mappite/aGotino/aGotino-wiring.png

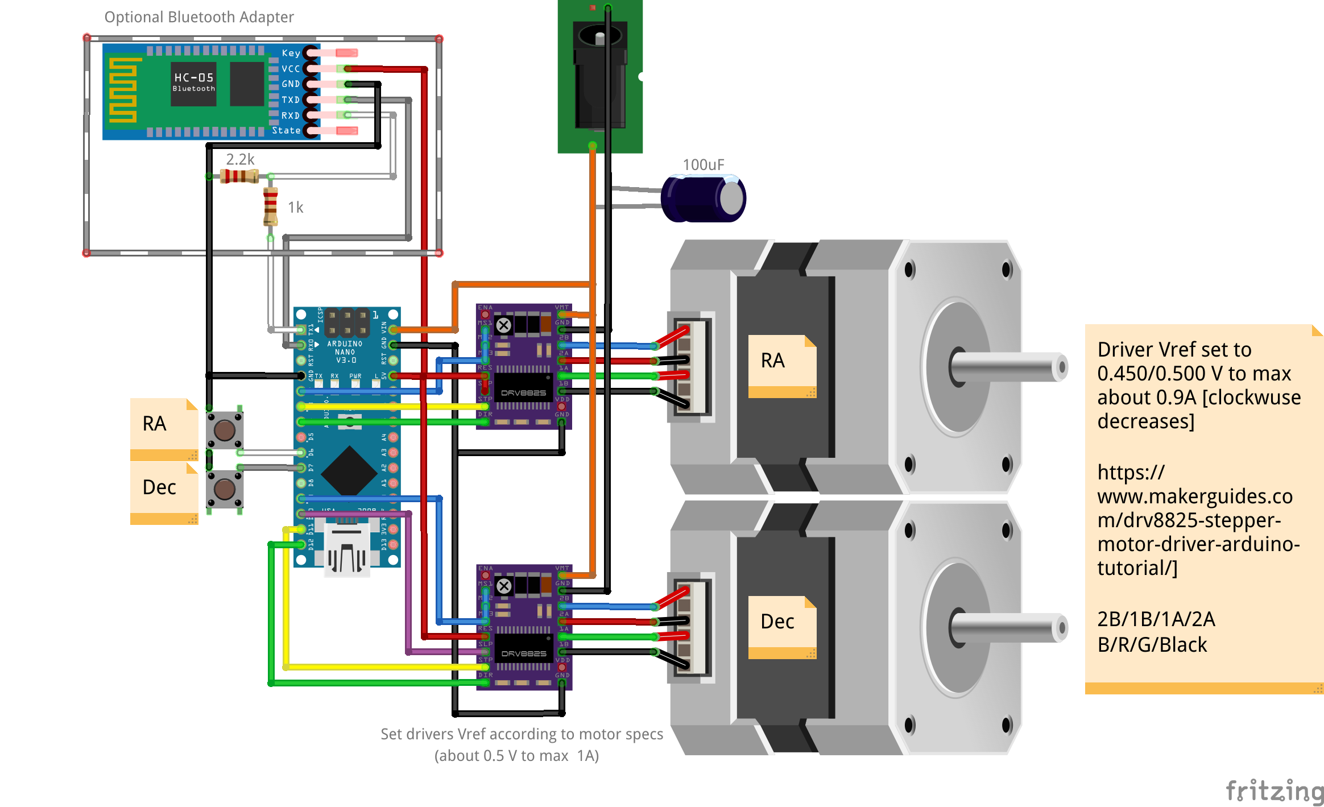
aGotino-wiring.png
