mappite/aGotino/(threads)

Thread 5 (2021-02-19):

Wrong GVP and GVN responses

polakovic, 2021-02-19:
Responses are not ended with '#' and thus protocol dialect detection is not possible.

eliboni, 2021-02-19:
Peter many thanks for the finding, you're right the final # is missed but it is required as per protocol specs. We'll fix it soon.

eliboni, 2021-02-20:
Fixed in main

eliboni, 2021-07-17:
@polakovic the issue is closed since some time but pls if you can confirm it is solved  I would appreciate. Thanks

polakovic, 2021-07-17:
Unfortunately I don't have such mount so I can't confirm it :(

Closed 2021-02-20.

Thread 6 (2022-01-04):

Figuring out maths for different mounts...

pepsiaddict82, 2022-01-04:
Hey I am just wondering about how to go about getting this rather important numbers right, first let me say thanks for your project and I hope to have it figured out here and be able to use it without having to make guesses in setting it all up!

Ok so I have a mount, its an astromaster mount, from what I can gather often times being called an eq2, now I understand its not the best mount to convert, but its what I have, as often is the argument when it comes to DIY stuff :) now then, when trying to figure out the maths,, I am instantly stuck on gathering numbers to input for a couple reasons, hopefully I can get some clarity.

First is the fact that I am direct driving the RA motor, so motor>coupler>RA worm..that spins the large gear on the RA. Question being the worm gear, how does one go about getting a number of teeth here?
For the DEC I have a large and small gear, so thats fine, but documentation doesnt really make things clear, as well the belt calculator you link to is largely irrelevant to most I assume, because this being a DIY project, can probably be safe to assume that mounting of motors is going to vary largely.

I am also quite curious about using the 2209's as drivers, I understand that for the most part these drivers pins are much the same, but just wanted to get a definitive understanding of what to connect where, being that one could argue the 2209 being the most popular driver in the wild today...

Not even sure if youre still doing anything with this project, but I figured I would take a shot and ask here first, rather than a 3rd party site.

Thanks for your time

eliboni, 2022-01-06:
I suggest to post this question on CloudyNight/Stargazer  or similar forums where somebody may already know the answers your are looking  for an eq2. One way to find the worm gear ratio is to mark the initial RA position and turn knob n times until the marker is back to the original position (if I remember correctly it could be 1:138). For the driver I can't help much, this is the issue list for agotino code, you'll get more inputs in astronomy diy forums.

Closed 2022-03-03.

Thread 8 (2022-09-01):

Is there a way to convert this code for alt-az mount

Neoxxgr, 2022-09-01:

eliboni, 2022-09-07:
Hi Neoxxgr, well the right answer is "yes" but the effort is quite big.

The main challenge is that to convert eq coordinates to az ones, we need to now exact lat/lng of the scope plus the exact sidereal time: so this information need to be passed to aGotino, then aGotino shoudl do the math and drive the motors-

https://www.cloudynights.com/topic/652374-open-source-conversion-between-eq-and-az-coordinates/
https://www.astrogreg.com/convert_ra_dec_to_alt_az.html

Thread 11 (2022-11-19):

Calcolo ingranaggi e cinghia

sazizz, 2022-11-19:
Ciaooo, innanzitutto mitico il lavoro che hai svolto per aGotino tant'è che sto provando ad applicarlo sulla mia montatura Meade lXD 300, unico problema (momentaneamente) è il calcolo ingranaggi  e cinghia che non ho assolutamente capito 😅 quindi ti chiederei una mano se è possibile,  ho due ingranaggi uno da 16 ed uno da 60 denti 2mm ed una distanza di circa 4 cm dal centro dei due ingranaggi, come faccio a calcolare effettivamente la cinghia? Grazie milleeee

eliboni, 2022-11-20:
@sazizz non mi è chiaro che calcolo ti serve, se hai i due ingranaggi il rapporto  60/16 è 3.75 quindi devi usare questo fattore per calcolare  MICROSTEPS_PER_DEGREE_AR  = WormRatio*(3.75)*StepsPerRevolution*Microsteps/360
Il WormRatio dipende dalla montatura, mentre StepsPerRevolution e Microsteps dipendono dal tipo di motore. Lunghezza cinghis o diametro ingranaggi è ininfluente per il calcolo (non cambia i rapporti).

In ogni caso, questa discussione su GitHub è per aspetti tecnici/contributi al codice etc, per domande generiche puoi utilizzare: https://www.astronomia.com/forum/showthread.php?34605-aGotino-un-goto-con-Arduino

Ciao!

Thread 13 (2023-11-08):

Bluetooth communication problem

martinapri, 2023-11-08:
Hello, I have connected via bluetooth with android smartphone and HC-05 appliance and received "aGotino ready"  welcome, but when I am sending any command, for example: s m31 no response receiving. I see RX led blinking for a moment, so my command was received but no information is generating in Serial Bluetooth Terminal.

Closed 2023-11-12.
