mappite/aGotino/catalogs.h

/* aGotino catalog.h
 *  
 *  Contains 
 *   Messier objects (110),  aGotino Star List (238) in Epoch J2000
 *   NGC objects Up to mag 11 (738) in B2000
 * 
 *  Copy this file in same folder of aGotino.ino
 */
#include <avr/pgmspace.h>

#define ELEMENTS(x) (sizeof(x) / sizeof(x[0]))

typedef struct {
     long ra, dec;
}  RaDec; // 8 byte

/* Messier Catalog
 *  Source: Wikipedia https://en.wikipedia.org/wiki/Messier_object
 */
const RaDec Messier[] PROGMEM = {
{0,0},          // Dummy so M[n] is Mn
{20071,79252},  // M1 05h 34m 31.94s +22° 00′ 52.2″
{77607,-2964},  // M2 21h 33m 27.02s −00° 49′ 24″
{49331,102158}, // M3 13h 42m 11.62s +28° 22′ 38.2″
{59015,-95492}, // M4 16h 23m 35.22s −26° 31′ 32.7″
{55113,7491},   // M5 15h 18m 33.22s +02° 04′ 51.7″
{63600,-115980},// M6 17h 40.1m −32° 13′
{64431,-125254},// M7 17h 53m 51.2s −34° 47′ 34″
{65017,-87792}, // M8 18h 03m 37s −24° 23′ 12″
{62351,-66658}, // M9 17h 19m 11.78s −18° 30′ 58.5″
{61029,-14758}, // M10 16h 57m 8.92s −04° 05′ 58.07″
{67866,-22560}, // M11 18h 51.1m −06° 16′
{60434,-7015},  // M12 16h 47m 14.18s −01° 56′ 55″
{60101,131255}, // M13 16h 41m 41.24s +36° 27′ 35.5″
{63456,-11685}, // M14 17h 37m 36.15s −03° 14′ 45.3″
{77398,43801},  // M15 21h 29m 58.33s +12° 10′ 01.2″
{65928,-49740}, // M16 18h 18m 48s −13° 49′
{66026,-58236}, // M17 18h 20m 26s −16° 10′ 36″
{65994,-61680}, // M18 18h 19.9m −17° 08′
{61357,-94565}, // M19 17h 02m 37.69s −26° 16′ 05″
{64943,-82908}, // M20 18h 02m 23s −23° 01′ 48″
{65076,-81000}, // M21 18h 04.6m −22° 30′
{66983,-86057}, // M22 18h 36m 23.94s −23° 54′ 17.1″
{64608,-68460}, // M23 17h 56.8m −19° 01′
{65820,-66780}, // M24 18h 17m −18° 33′
{66696,-69300}, // M25 18h 31.6m −19° 15′
{67512,-33840}, // M26 18h 45.2m −09° 24′
{71976,81796},  // M27 19h 59m 36.340s +22° 43′ 16.09″
{66272,-89531}, // M28 18h 24m 32.89s −24° 52′ 11.4″
{73436,138684}, // M29 20h 23m 56s +38° 31′ 24″
{78022,-83447}, // M30 21h 40m 22.12 −23° 10′ 47.5″
{2564,148569},  // M31 00h 42m 44.3s +41° 16′ 09″
{2561,147115},  // M32 00h 42m 41.8s +40° 51′ 55″
{5630,110377},  // M33 01h 33m 50.02s +30° 39′ 37″
{9726,153960},  // M34 02h 42.1m +42° 46′
{22146,87660},  // M35 06h 09.1m +24° 21′
{20172,122884}, // M36 05h 36m 12s +34° 08′ 04″
{21138,117182}, // M37 05h 52m 18s +32° 33′ 02″
{19722,129078}, // M38 05h 28m 42s +35° 51′ 18″
{77502,174360}, // M39 21h 31m 42s +48° 26′ 00″
{44532,209099}, // M40 12h 22m 12.5s +58° 04′ 59″
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
};

/* aGotino Star List
 *  Contains all constellations Alpha, Beta and Gamma stars 
 *  with mag < 4 and the all remaining stars with mag <3
 * Source: 
 *  BSC5P - Bright Star Catalog	https://heasarc.gsfc.nasa.gov/W3Browse/star-catalog/bsc5p.html
 *  Names from Kstars project https://edu.kde.org/kstars/ * 
 */

const RaDec Stars[] PROGMEM = {		
{0,324000},     // True North
{503,104726},  // (1) And Alp  Alpheratz
{4184,128234},  // (2) And Bet  Mirach
{7434,152387},  // (3) And Gam  Almach
{53272,-284561},  // (4) Aps Alp  
{59607,-284030},  // (5) Aps Gam  
{71447,31926},  // (6) Aql Alp  Altair
{71719,23064},  // (7) Aql Bet  Alshain
{71176,38208},  // (8) Aql Gam  Tarazed
{68725,49908},  // (9) Aql Zet  
{79547,1151}, // (10) Aqr Alp Sadalmelik
{77494,-20056}, // (11) Aqr Bet Sadalsud
{80499,-4994},  // (12) Aqr Gam Sadachbia
{63111,-179554},  // (13) Ara Alp Tchou
{62718,-199908},  // (14) Ara Bet 
{62724,-202959},  // (15) Ara Gam 
{7630,84465}, // (16) Ari Alp Hamal
{6878,74909}, // (17) Ari Bet Sheratan
{19001,165593}, // (18) Aur Alp Capella
{21572,161811}, // (19) Aur Bet Menkalinan
{18118,157764}, // (20) Aur Eps Maaz
{17820,119398}, // (21) Aur Iot Kabdhilinan
{21583,133965}, // (22) Aur The 
{51340,69057},  // (23) Boo Alp Arcturus
{54117,145406}, // (24) Boo Bet Nekkar
{53099,97467},  // (25) Boo Eps Pulcherrima
{50081,66232},  // (26) Boo Eta Muphrid
{52325,137910}, // (27) Boo Gam Seginus
{73083,-45161}, // (28) Cap Alp Al Giedi
{73261,-53213}, // (29) Cap Bet Dabih
{78422,-58058}, // (30) Cap Del Deneb Algiedi
{78006,-59984}, // (31) Cap Gam Nashira
{23037,-189705},  // (32) Car Alp Canopus
{33192,-250982},  // (33) Car Bet Miaplacidus
{30151,-214235},  // (34) Car Eps Avior
{33425,-213391},  // (35) Car Iot Aspidiske
{38577,-231820},  // (36) Car The 
{2431,203534},  // (37) Cas Alp Schedar
{551,212939}, // (38) Cas Bet Caph
{5149,216847},  // (39) Cas Del Ruchbah
{3403,218580},  // (40) Cas Gam Navi
{52776,-219007},  // (41) Cen Alp Rigel Kentaurus
{50629,-217343},  // (42) Cen Bet Hadar
{43702,-182601},  // (43) Cen Del 
{49193,-192479},  // (44) Cen Eps 
{52530,-151768},  // (45) Cen Eta 
{45691,-176255},  // (46) Cen Gam 
{48036,-132164},  // (47) Cen Iot 
{50801,-130932},  // (48) Cen The Menkent
{50132,-170238},  // (49) Cen Zet 
{76715,225308}, // (50) Cep Alp Alderamin
{77320,254019}, // (51) Cep Bet Alphirk
{85161,279477}, // (52) Cep Gam Er Rai
{10937,14723},  // (53) Cet Alp Menkab
{2615,-64752},  // (54) Cet Bet Diphda
{9798,11649}, // (55) Cet Gam 
{52950,-233911},  // (56) Cir Alp 
{24309,-60178}, // (57) CMa Alp Sirius
{22962,-64641}, // (58) CMa Bet Mirzam
{25704,-95016}, // (59) CMa Del Wezen
{25118,-104300},  // (60) CMa Eps Adhara
{26646,-105491},  // (61) CMa Eta Aludra
{27558,18810},  // (62) CMi Alp Procyon
{26829,29842},  // (63) CMi Bet Gomeisa
{29791,33068},  // (64) Cnc Bet Tarf
{20379,-122667},  // (65) Col Alp Phakt
{21058,-128766},  // (66) Col Bet Wazn
{56081,96173},  // (67) CrB Alp Alphecca
{55670,104781}, // (68) CrB Bet Nusakan
{56565,94664},  // (69) CrB Gam 
{44796,-227157},  // (70) Cru Alp Acrux
{46063,-214879},  // (71) Cru Bet Mimosa
{44109,-211496},  // (72) Cru Del 
{45070,-205608},  // (73) Cru Gam Gacrux
{45263,-84228}, // (74) Crv Bet Kraz
{44992,-59456}, // (75) Crv Del Algorab
{44148,-63151}, // (76) Crv Gam Gienah Corvi
{46562,137946}, // (77) CVn Alp Cor Caroli
{74486,163009}, // (78) Cyg Alp Deneb
{70243,100655}, // (79) Cyg Bet Albireo
{71099,162471}, // (80) Cyg Del 
{74773,122293}, // (81) Cyg Eps Gienah
{73334,144924}, // (82) Cyg Gam Sadr
{74378,57283},  // (83) Del Alp Svalocin
{74253,52543},  // (84) Del Bet Rotanev
{16440,-198162},  // (85) Dor Alp 
{20018,-224963},  // (86) Dor Bet 
{50663,231753}, // (87) Dra Alp Thuban
{63026,188285}, // (88) Dra Bet Rastaban
{59040,221451}, // (89) Dra Eta 
{64596,185360}, // (90) Dra Gam Eltanin
{76549,18892},  // (91) Equ Alp Kitalpha
{5863,-206052}, // (92) Eri Alp Achernar
{18471,-18311}, // (93) Eri Bet Cursa
{14282,-48631}, // (94) Eri Gam Zaurak
{11524,-104353},  // (95) For Alp 
{27276,114798}, // (96) Gem Alp Castor
{27919,100894}, // (97) Gem Bet Pollux
{24236,90472},  // (98) Gem Eps Mebsuta
{23863,59037},  // (99) Gem Gam Alhena
{22978,81049},  // (100) Gem Mu   Tejat
{79694,-169060},  // (101) Gru Alp  Al Na'ir
{81760,-168785},  // (102) Gru Bet  
{78836,-134514},  // (103) Gru Gam  Al Dhanab
{62079,51805},  // (104) Her Alp  Ras Algethi
{59413,77363},  // (105) Her Bet  Kornephoros
{58915,68951},  // (106) Her Gam  
{60077,113771}, // (107) Her Zet  
{15240,-152260},  // (108) Hor Alp  
{34055,-31171}, // (109) Hya Alp  Alphard
{47935,-83418}, // (110) Hya Gam  
{7126,-221651}, // (111) Hyi Alp  
{1545,-278115}, // (112) Hyi Bet  
{13634,-267260},  // (113) Hyi Gam  
{74254,-170249},  // (114) Ind Alp  Al Nair
{75289,-210435},  // (115) Ind Bet  
{81078,181017}, // (116) Lac Alp  
{36502,43082},  // (117) Leo Alp  Regulus
{42544,52459},  // (118) Leo Bet  Denebola
{40447,73885},  // (119) Leo Del  Zozma
{35151,85587},  // (120) Leo Eps  
{37198,71430},  // (121) Leo Gam  Al Gieba
{19964,-64160}, // (122) Lep Alp  Arneb
{19695,-74734}, // (123) Lep Bet  Nihal
{20668,-80814}, // (124) Lep Gam  
{53453,-57750}, // (125) Lib Alp  Zuben El Genubi
{55020,-33779}, // (126) Lib Bet  Zuben el Chamal
{56132,-53242}, // (127) Lib Gam  Zuben el Hakrab
{52916,-170598},  // (128) Lup Alp  Men
{53912,-155282},  // (129) Lup Bet  
{56109,-148201},  // (130) Lup Gam  
{33663,123813}, // (131) Lyn Alp  
{67016,139621}, // (132) Lyr Alp  Vega
{67805,120106}, // (133) Lyr Bet  Sheliak
{68337,117682}, // (134) Lyr Gam  Sulaphat
{27675,-34384}, // (135) Mon Alp  
{22491,-22589}, // (136) Mon Gam  
{45431,-248888},  // (137) Mus Alp  
{45977,-245189},  // (138) Mus Bet  
{45148,-259679},  // (139) Mus Gam  
{63296,45216},  // (140) Oph Alp  Rasalhague
{63808,16442},  // (141) Oph Bet  Kelb al Rai
{58461,-13300}, // (142) Oph Del  Yed Prior
{61823,-56609}, // (143) Oph Eta  
{64074,9746}, // (144) Oph Gam  
{59830,-38042}, // (145) Oph Zet  
{21310,26665},  // (146) Ori Alp  Betelgeuse
{18872,-29526}, // (147) Ori Bet  Rigel
{19920,1077}, // (148) Ori Del  Mintaka
{20173,-4327},  // (149) Ori Eps  Alnilam
{19508,22859},  // (150) Ori Gam  Bellatrix
{20126,-21276}, // (151) Ori Iot  Na'ir al Saif
{20865,-34811}, // (152) Ori Kap  Saiph
{20446,-6994},  // (153) Ori Zet  Alnitak
{73539,-204246},  // (154) Pav Alp  Peacock
{74698,-238331},  // (155) Pav Bet  
{83086,54739},  // (156) Peg Alp  Markab
{83027,101098}, // (157) Peg Bet  Scheat
{78251,35550},  // (158) Peg Eps  Enif
{81780,108797}, // (159) Peg Eta  Matar
{794,54661},  // (160) Peg Gam  Algenib
{12259,179500}, // (161) Per Alp  Mirfak
{11290,147440}, // (162) Per Bet  Algol
{14271,144037}, // (163) Per Eps  
{11088,192623}, // (164) Per Gam  
{14048,114781}, // (165) Per Zet  Atik
{1577,-152302}, // (166) Phe Alp  Ankaa
{3965,-168187}, // (167) Phe Bet  
{5302,-155946}, // (168) Phe Gam  
{24491,-222989},  // (169) Pic Alp  
{20837,-183839},  // (170) Pic Bet  
{82659,-106640},  // (171) PsA Alp  Fomalhaut
{83830,11816},  // (172) Psc Gam  
{26229,-133551},  // (173) Pup Pi   
{29253,-87495}, // (174) Pup Rho  
{24596,-182213},  // (175) Pup Tau  
{29015,-144012},  // (176) Pup Zet  Naos
{31416,-119471},  // (177) Pyx Alp  
{31206,-127110},  // (178) Pyx Bet  
{15266,-224906},  // (179) Ret Alp  
{13452,-233305},  // (180) Ret Bet  
{59364,-95155}, // (181) Sco Alp  Antares
{57926,-71300}, // (182) Sco Bet  Graffias
{57620,-81438}, // (183) Sco Del  Dschubba
{60610,-123456},  // (184) Sco Eps  
{63749,-140508},  // (185) Sco Kap  
{63217,-133574},  // (186) Sco Lam  Shaula
{57531,-94011}, // (187) Sco Pi   
{58871,-92134}, // (188) Sco Sig  Al Niyat
{59753,-101578},  // (189) Sco Tau  
{63439,-154792},  // (190) Sco The  Sargas
{63046,-134265},  // (191) Sco Ups  Lesath
{66912,-29679}, // (192) Sct Alp  
{56656,23132},  // (193) Ser Alp  Unukalhai
{56771,55519},  // (194) Ser Bet  Chow
{57387,56382},  // (195) Ser Gam  
{71925,70172},  // (196) Sge Gam  
{69833,-146218},  // (197) Sgr Alp  
{66060,-107381},  // (198) Sgr Del  Kaus Media
{66250,-123785},  // (199) Sgr Eps  Kaus Australis
{65149,-109527},  // (200) Sgr Gam  Al Nasl
{66478,-91518}, // (201) Sgr Lam  Kaus Borealis
{68986,-75685}, // (202) Sgr Pi   
{68116,-94668}, // (203) Sgr Sig  Nunki
{68557,-107569},  // (204) Sgr Zet  
{16555,59433},  // (205) Tau Alp  Aldebaran
{19578,102987}, // (206) Tau Bet  Alnath
{13649,86778},  // (207) Tau Eta  Alcyone
{15588,56259},  // (208) Tau Gam  Primus Hyadum
{66418,-165486},  // (209) Tel Alp  
{60520,-248500},  // (210) TrA Alp  
{57309,-228350},  // (211) TrA Bet  
{55135,-247246},  // (212) TrA Gam  
{6785,106484},  // (213) Tri Alp  Mothallah
{7773,125954},  // (214) Tri Bet  
{1446,-259493}, // (215) Tuc 47 
{80310,-216935},  // (216) Tuc Alp  
{83846,-209649},  // (217) Tuc Gam  
{39824,222303}, // (218) UMa Alp  Dubhe
{39711,202977}, // (219) UMa Bet  Merak
{46442,201455}, // (220) UMa Eps  Alioth
{49652,177528}, // (221) UMa Eta  Alkaid
{42830,193301}, // (222) UMa Gam  Phecda
{48236,197731}, // (223) UMa Zet  Mizar
{9109,321351},  // (224) UMi Alp  Polaris
{53442,266960}, // (225) UMi Bet  Kocab
{55244,258602}, // (226) UMi Gam  Pherkab
{31482,-196950},  // (227) Vel Del  
{29372,-170412},  // (228) Vel Gam  Regor
{33727,-198039},  // (229) Vel Kap  Merkab
{32880,-156357},  // (230) Vel Lam  Suhail
{38806,-177912},  // (231) Vel Mu   
{48312,-40181}, // (232) Vir Alp  Spica
{42642,6353}, // (233) Vir Bet  Zawijah
{46931,39453},  // (234) Vir Eps  Vindemiatrix
{45700,-5218},  // (235) Vir Gam  
{32547,-239026},  // (236) Vol Alp  
{30344,-238093},  // (237) Vol Bet  
{25725,-253796},  // (238) Vol Gam  
};


typedef struct {
   int id; // up to 32767
   long ra, dec;
}  NGC; // sorted by id

/* NCG Objects with Mag up to 11
 *  Source: NGC 2000.0, The Complete New General Catalogue and Index Catalogue
                        of Nebulae and Star Clusters by J.L.E. Dreyer
 *
 * Up to mag 12, 1167 items: 29160 bytes (94%) of program storage space
 * Up to mag 11,  738 items: 24870 bytes (80%) of program storage space
 */

const NGC NGCs[] PROGMEM = {    
{45, 846, -83460},
{55, 894, -141060},
{103, 1518, 220860},
{104, 1446, -259500},
{121, 1608, -257520},
{129, 1794, 216840},
{133, 1872, 228120},
{134, 1824, -119700},
{146, 1986, 227880},
{147, 1992, 174600},
{157, 2088, -30240},
{185, 2340, 174000},
{188, 2640, 307200},
{189, 2376, 219840},
{205, 2424, 150060},
{210, 2436, -49920},
{221, 2562, 147120},
{224, 2562, 148560},
{225, 2604, 222420},
{246, 2820, -42780},
{247, 2826, -74760},
{253, 2856, -91020},
{278, 3126, 171180},
{281, 3168, 203820},
{288, 3168, -95700},
{300, 3294, -135660},
{330, 3372, -260940},
{346, 3546, -259860},
{362, 3792, -255060},
{381, 4098, 221700},
{404, 4164, 128580},
{419, 4098, -262380},
{436, 4536, 211740},
{457, 4746, 210000},
{488, 4908, 18900},
{524, 5088, 34320},
{559, 5370, 227880},
{578, 5430, -81600},
{581, 5592, 218520},
{584, 5478, -24720},
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
};

int ngcLookup(int ncgId) {
  // binary search 
  int first = 0;
  int last  = ELEMENTS(NGCs);
  int mid;
  int id;
  while ( first <= last ) {
    mid = (first + last)/2;
    id = (int) pgm_read_word(&(NGCs[mid].id));
    if (id < ncgId ) {
      first = mid+1;
    } else if (id > ncgId ) {
      last = mid-1;
    } else { // found!
      return mid;
    }
  }
  return -1; // not found
}
