mappite/aGotino/(commit log)

2020-10-26 v2
    Contains all α, β, γ constellations stars up to mag 4 plus the other stars up to mag 3. For sources, see catalog.h
2020-10-26 Wiring Schema (created with Fritzing)
2020-10-27 rRRRRdDDDD signs inverted to honor results. Max ranges check
    [aGotino.ino, catalogs.h]
2020-10-27 Update aGotino print coords to add leading 0 on m and s if <10
2020-10-27 Fix range validation in rRRRRdDDDD
    [aGotino.ino]
2020-11-07 Fix to consider meridian flip in delta RA secs
    [aGotino.ino]
2020-11-21 Accelleration on slew. Resolves Dec glitch when sleep is active
    [aGotino.ino]
2020-11-21 Interrupt for RA tracking
2020-11-22 Refined interrupt for RA tracking
2020-11-22 Side Of Pier can be changed pressing both buttons for 1sec
2020-12-03 fix max range print value
    [aGotino.ino]
2020-12-14 Reset RA and stop Dec motors when side of pier change occurs
    [aGotino.ino]
2020-12-29 bugfix: +speed increment on Dec axis
    [aGotino.ino]
2021-01-06 Fix negative Dec errors in catalogs.h
    [aGotino.ino, catalogs.h]
2021-01-07 Received command is printed if unknown
2021-01-09 Bug Fix: negative Dec conversion in LX200
    [aGotino.ino]
2021-06-30 RA button press direction reversed
    [aGotino.ino]
2023-02-27 Fixed long overflow when slewing more than 46 degrees
    [aGotino.ino]
2023-03-09 TMC drivers setup
2023-03-12 Update README.md
    Added motor drivers section
